leseaw/PrntrBoard/PrntrBoardV1.kicad_pcb

## KiCad design PrntrBoardV1.kicad_pcb (2019-01-21)

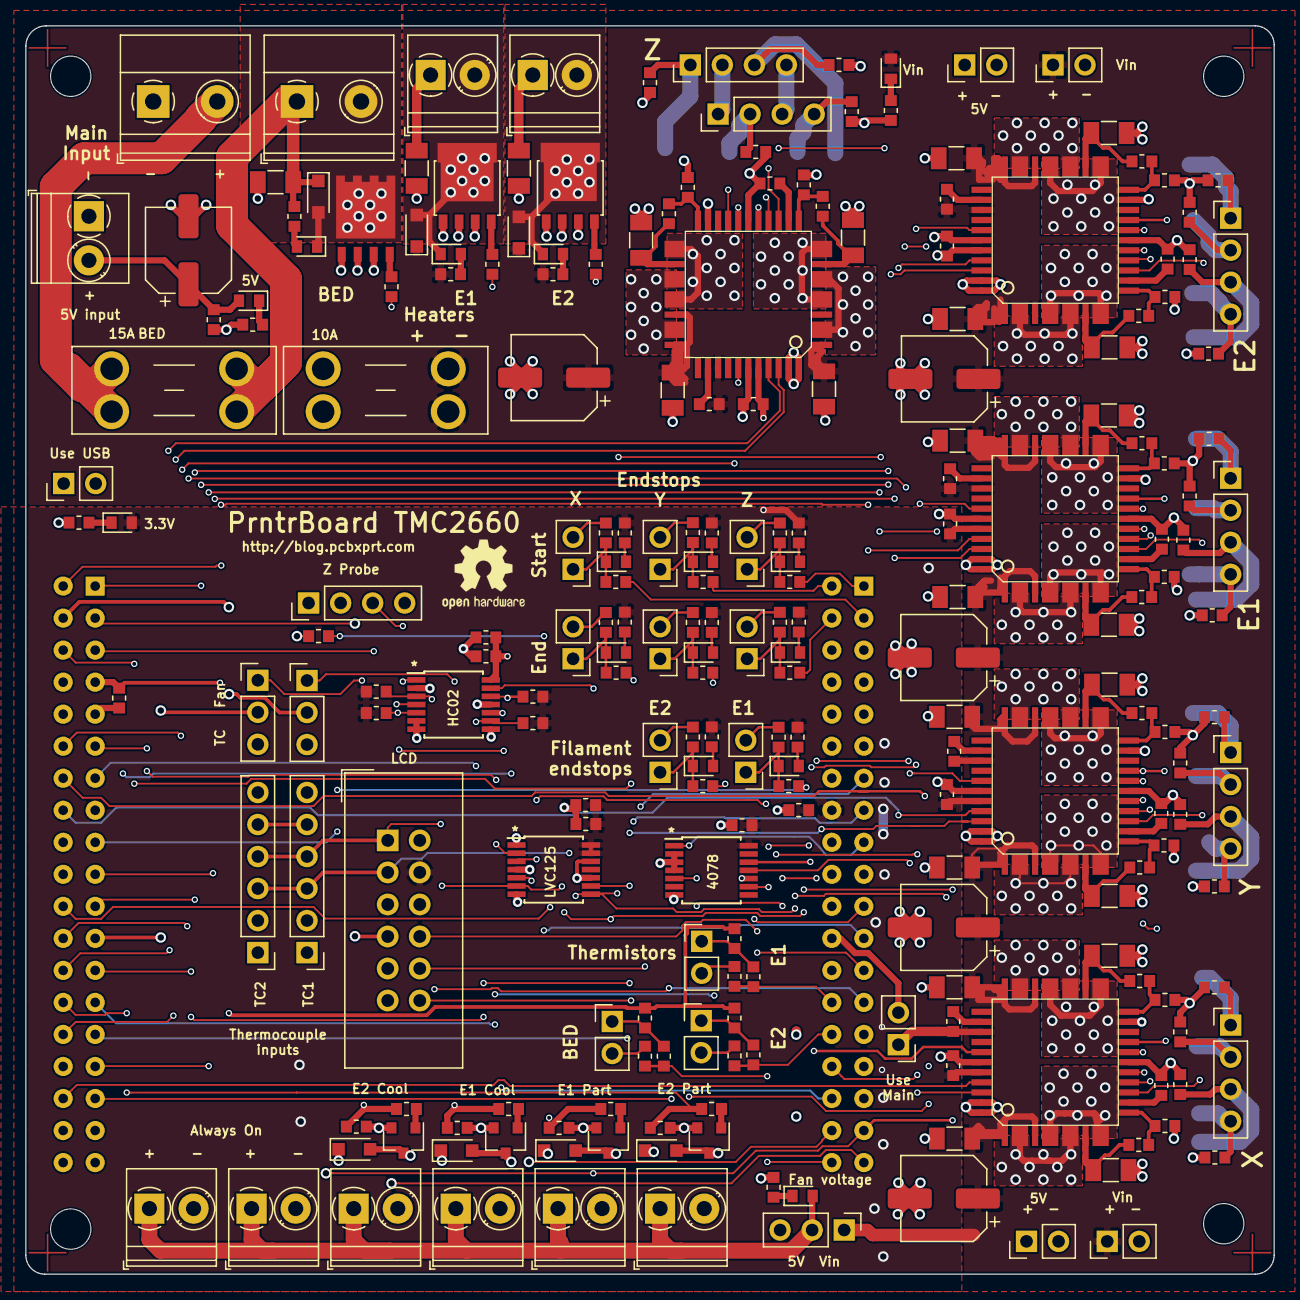
[picture p1: board PrntrBoardV1.kicad_pcb from above]

Board: 4 copper layers, 99.0 x 99.0 mm, 238 parts (1 on the bottom side), 165 nets.

Parts:
C1, C5: 10uF 10V; C_0603_1608Metric
C2: 100uF; CP_Elec_6.3x7.7
C3, C6, C8, C22, C23, C37, C38, C51, C52, C65, C66, C79, C80, C82: 1000pF; C_0603_1608Metric
C4, C7, C9, C15, C30, C44, C58, C72: 0.1uF; C_0603_1608Metric
C10, C11, C24, C25, C26, C39, C40, C53, C54, C67, C68, C81, C83: 10uF 50V; C_1206_3216Metric
C12, C27, C41, C55, C69: 100uF 35V; CP_Elec_6.3x7.7
C13, C28, C42, C56, C70: 0.1uF 50V; C_0603_1608Metric
C14, C29, C43, C57, C71: 0.47uF; C_0603_1608Metric
C16, C21, C31, C36, C45, C50, C59, C64, C73, C78: 0.01uF X7R 10% 50V; C_0603_1608Metric
C17, C18, C19, C20, C32, C33, C34, C35, C46, C47, C48, C49, C60, C61, C62, C63, C74, C75, C76, C77: 1000pF >50V; C_0603_1608Metric
D1, D2, D3, D4, D5, D6, D8, D9, D10, D11, D12, D13, D14, D15, D17: LED; LED_0603_1608Metric
D7, D16, D18, D19, D20, D21, D22: 1N4148; D_SOD-323_HandSoldering
F1: 10A; Fuseholder_Blade_Mini_Keystone_3568
F2: 15A; Fuseholder_Blade_Mini_Keystone_3568
FID1, FID2, FID3, FID4: Fiducial; Fiducial_1mm_Dia_2.54mm_Outer_CopperTop
J1: 12-24V; TerminalBlock_Phoenix_MKDS-1,5-2-5.08_1x02_P5.08mm_Horizont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
J2: EXT 5V; TerminalBlock_Phoenix_PT-1,5-2-3.5-H_1x02_P3.50mm_Horizontal
J3, J4: Vin; PinHeader_1x02_P2.54mm_Vertical
J5, J6: 5V; PinHeader_1x02_P2.54mm_Vertical
J7: Bed Heater; TerminalBlock_Phoenix_MKDS-1,5-2-5.08_1x02_P5.08mm_Horizont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
J8: Z Probe; PinHeader_1x04_P2.54mm_Vertical
J9: E0 Cool; TerminalBlock_Phoenix_PT-1,5-2-3.5-H_1x02_P3.50mm_Horizontal
J10: E0 Part; TerminalBlock_Phoenix_PT-1,5-2-3.5-H_1x02_P3.50mm_Horizontal
J11: E1 Cool; TerminalBlock_Phoenix_PT-1,5-2-3.5-H_1x02_P3.50mm_Horizontal
J12: E1 Part; TerminalBlock_Phoenix_PT-1,5-2-3.5-H_1x02_P3.50mm_Horizontal
J13: Always On Fan 1; TerminalBlock_Phoenix_PT-1,5-2-3.5-H_1x02_P3.50mm_Horizontal
J14: Always On Fan 2; TerminalBlock_Phoenix_PT-1,5-2-3.5-H_1x02_P3.50mm_Horizontal
J15: TC1; PinHeader_1x06_P2.54mm_Vertical
J16: TC2; PinHeader_1x06_P2.54mm_Vertical
J17, J31: Probe; PinHeader_1x02_P2.54mm_Vertical
J18, J32: Extruder Heater; TerminalBlock_Phoenix_PT-1,5-2-3.5-H_1x02_P3.50mm_Horizontal
J19, J27, J28, J29, J30, J33: Stepper; PinHeader_1x04_P2.54mm_Vertical
J20, J34, J35: Thermistor; PinHeader_1x02_P2.54mm_Vertical
J21, J23, J25: Max; PinHeader_1x02_P2.54mm_Vertical
J22, J24, J26: Min; PinHeader_1x02_P2.54mm_Vertical
J36: LCD; IDC-Header_2x06_P2.54mm_Vertical
JP1: E1_TC2; PinHeader_1x03_P2.54mm_Vertical
JP2: Use VIn; PinHeader_1x02_P2.54mm_Vertical
JP3: Use USB; PinHeader_1x02_P2.54mm_Vertical
JP4: E0_TC1; PinHeader_1x03_P2.54mm_Vertical
JP5: FAN Voltage select; PinHeader_1x03_P2.54mm_Vertical
LOGO1: Logo_Open_Hardware_Large; OSHW-Logo2_7.3x6mm_SilkScreen
MK1: Mounting_Hole; MountingHole_3.2mm_M3
MK2, MK3, MK4: Mounting_Hole_3mm; MountingHole_3.2mm_M3
R1, R3, R4, R5, R6, R7, R9, R15, R17, R19, R25, R27, R33, R35, R41, R43, R49, R51, R53, R55, R57, R58, R60, R62, R64: 10k; R_0603_1608Metric
R2, R8, R14, R24, R26, R32, R34, R40, R42, R48, R59, R61, R63, R65: 1k; R_0603_1608Metric
R10, R12, R20, R22, R28, R30, R36, R38, R44, R46: 22R; R_0603_1608Metric
R11, R13, R21, R23, R29, R31, R37, R39, R45, R47: 0R051; R_1206_3216Metric
R16, R50, R54: 4k7 1%; R_0603_1608Metric
R18, R52, R56: 180R; R_0603_1608Metric
TR1, TR2: PSMN7R0-30YL; SOT-669_LFPAK
TR3: BSC011N03LS; PG-TDSON-8-FL
TR4, TR5, TR6, TR7: SI2318CDS; SOT-23
U1: NUCLEO-64; Nucleo-64
U2: 4078; TSSOP-14_4.4x5mm_P0.65mm
U3: 74HCT02; TSSOP-14_4.4x5mm_P0.65mm
U4: 74LVC125; TSSOP-14_4.4x5mm_P0.65mm
U5, U6, U7, U8, U9: TMC2660

Connections:
/3.3V: C1.1, C4.1, C8.1, C9.1, C15.1, C30.1, C44.1, C58.1, C72.1, D2.2, J36.4, R3.1, R4.1, R5.1, R6.1, R14.1, R24.1, R26.1, R32.1, R34.1, R40.1, R42.1, R48.1, U1.16, U2.14, U4.13, U4.14, U5.40, U6.40, U7.40, U8.40, U9.40
/5V: C2.1, C3.1, C6.1, C7.1, D3.2, J2.2, J5.1, J6.1, J8.4, J15.1, J16.1, J36.2, JP3.2, JP5.3, U1.6, U3.14
/AVREF: C5.1, R16.1, R50.1, R54.1, U1.45
/BED_PWM_IN: R6.2, U1.34, U3.5
/BED_TEMP: C82.1, R55.1, U1.38
/BTN_IN: J36.8, U1.25
/E0 Cooling Fan/OUT: D19.2, J9.2, TR4.D
/E0 Cooling Fan/V_FAN: D4.2, D19.1, D20.1, D21.1, D22.1, J9.1, J10.1, J11.1, J12.1, J13.1, J14.1, JP5.2
/E0 Part Fan/OUT: D20.2, J10.2, TR5.D
/E0_COOL_PWM: JP4.1, R58.1, R59.2
/E0_COOL_TC1: JP4.2, U1.42
/E0_DIR: U1.40, U5.41
/E0_END: R15.1, U1.55
/E0_PART_PWM: R60.1, R61.2, U1.60
/E0_PWM: R18.2, U3.10
/E0_PWM_IN: R4.2, U1.51, U3.9
/E0_STEP: U1.57, U5.42
/E0_TEMP: C23.1, R17.1, U1.28
/E1 Cooling Fan/OUT: D21.2, J11.2, TR6.D
/E1 Part Fan/OUT: D22.2, J12.2, TR7.D
/E1_COOL_PWM: JP1.1, R62.1, R63.2
/E1_COOL_TC2: JP1.2, U1.61
/E1_DIR: U1.59, U9.41
/E1_END: R49.1, U1.21
/E1_PART_PWM: R64.1, R65.2, U1.66
/E1_PWM: R52.2, U3.13
/E1_PWM_IN: R5.2, U1.53, U3.12
/E1_STEP: U1.39, U9.42
/E1_TEMP: C80.1, R51.1, U1.30
/ENC_A: J36.10, U1.13
/ENC_B: J36.12, U1.15
/Heated Bed/HEATER: D17.1, D18.2, J7.2, TR3.D
/Heated Bed/PWM: R56.2, U3.4
/Heated Bed/V_HEAT: C83.1, D18.1, F2.2, J7.1, R57.1
/LCD_A0: J36.5, U1.43
/MISO: J15.5, J16.5, U1.35, U5.14, U6.14, U7.14, U8.14, U9.14
/MOSI: U1.36, U4.5
/MOSI_BUF: J15.4, J16.4, J36.1, U4.6, U5.15, U6.15, U7.15, U8.15, U9.15
/MotorControl/E0/Driver/MOTA1: C17.2, J19.3, U5.2.3, U5.7.8
/MotorControl/E0/Driver/MOTA2: C18.2, J19.4, U5.5.6, U5.10.1
/MotorControl/E0/Driver/MOTB1: C19.2, J19.1, U5.26.7, U5.31.2
/MotorControl/E0/Driver/MOTB2: C20.2, J19.2, U5.23.4, U5.28.9
/MotorControl/E0/Fimalent Detect/SENSOR: C22.1, D5.1, J17.1, R15.2
/MotorControl/E0/Heating/HEATER: D6.1, D7.2, J18.2, TR1.D
/MotorControl/E0/~ENABLE: U4.3, U5.19, U6.19, U7.19, U8.19, U9.19
/MotorControl/E0_SG: U2.9, U5.38
/MotorControl/E1/Driver/MOTA1: C74.2, J33.3, U9.2.3, U9.7.8
/MotorControl/E1/Driver/MOTA2: C75.2, J33.4, U9.5.6, U9.10.1
/MotorControl/E1/Driver/MOTB1: C76.2, J33.1, U9.26.7, U9.31.2
/MotorControl/E1/Driver/MOTB2: C77.2, J33.2, U9.23.4, U9.28.9
/MotorControl/E1/Fimalent Detect/SENSOR: C79.1, D14.1, J31.1, R49.2
/MotorControl/E1/Heating/HEATER: D15.1, D16.2, J32.2, TR2.D
/MotorControl/E1_SG: U2.5, U9.38
/MotorControl/X Axis/MOTA1: C32.2, J27.3, U6.2.3, U6.7.8
/MotorControl/X Axis/MOTA2: C33.2, J27.4, U6.5.6, U6.10.1
/MotorControl/X Axis/MOTB1: C34.2, J27.1, U6.26.7, U6.31.2
/MotorControl/X Axis/MOTB2: C35.2, J27.2, U6.23.4, U6.28.9
/MotorControl/X Axis/MaxStop/SENSOR: C37.1, D8.1, J21.1, R25.2
/MotorControl/X Axis/MinStop/SENSOR: C38.1, D9.1, J22.1, R27.2
/MotorControl/X_SG: U2.12, U6.38
/MotorControl/Y Axis/MOTA1: C46.2, J28.3, U7.2.3, U7.7.8
/MotorControl/Y Axis/MOTA2: C47.2, J28.4, U7.5.6, U7.10.1
/MotorControl/Y Axis/MOTB1: C48.2, J28.1, U7.26.7, U7.31.2
/MotorControl/Y Axis/MOTB2: C49.2, J28.2, U7.23.4, U7.28.9
/MotorControl/Y Axis/MaxStop/SENSOR: C51.1, D10.1, J23.1, R33.2
/MotorControl/Y Axis/MinStop/SENSOR: C52.1, D11.1, J24.1, R35.2
/MotorControl/Y_SG: U2.11, U7.38
/MotorControl/Z Axis/MOTA1: C60.2, J30.3, U8.2.3, U8.7.8
/MotorControl/Z Axis/MOTA2: C61.2, J29.4, U8.5.6, U8.10.1
/MotorControl/Z Axis/MOTB1: C62.2, J30.1, U8.26.7, U8.31.2
/MotorControl/Z Axis/MOTB2: C63.2, J29.2, U8.23.4, U8.28.9
/MotorControl/Z Axis/MaxStop/SENSOR: C65.1, D12.1, J25.1, R41.2
/MotorControl/Z Axis/MinStop/SENSOR: C66.1, D13.1, J26.1, R43.2
/MotorControl/Z Motors/Motor1/MOTA1: J29.3, J30.4
/MotorControl/Z Motors/Motor1/MOTB1: J29.1, J30.2
/MotorControl/Z_SG: U2.10, U8.38
/SCK: U1.63, U4.9
/SCK_BUF: J15.3, J16.3, J36.3, U4.8, U5.16, U6.16, U7.16, U8.16, U9.16
/STALL: U1.17, U2.1
/VBUS: JP3.1, U1.46
/V_MOTORS: C10.1, C11.1, C12.1, C13.1, C24.1, C25.1, C26.1, C27.1, C28.1, C39.1, C40.1, C41.1, C42.1, C53.1, C54.1, C55.1, C56.1, C67.1, C68.1, C69.1, C70.1, C81.1, D1.2, D7.1, D16.1, F1.1, J3.1, J4.1, J18.1, J32.1, JP2.1, JP5.1, R19.1, R53.1, U5.1, U5.4, U5.30, U5.33, U5.36, U6.1, U6.4, U6.30, U6.33, U6.36, U7.1, U7.4, U7.30, U7.33, U7.36, U8.1, U8.4, U8.30, U8.33, U8.36, U9.1, U9.4, U9.30, U9.33, U9.36
/Vin: F1.2, F2.1, J1.2
/X_DIR: U1.72, U6.41
/X_END: R25.1, U1.4
/X_START: R27.1, U1.1
/X_STEP: U1.32, U6.42
/Y_DIR: U1.54, U7.41
/Y_END: R33.1, U1.65
/Y_START: R35.1, U1.2
/Y_STEP: U1.44, U7.42
/Z_DIR: U1.64, U8.41
/Z_END: R41.1, U1.67
/Z_PROBE_IN: R8.1, U1.23
/Z_PROBE_MOD: R3.2, U1.27, U3.3
/Z_PROBE_MOD_BUF: J8.3, U3.1
/Z_START: R43.1, U1.3
/Z_STEP: U1.68, U8.42
/~E0_CS: U1.69, U5.18
/~E1_CS: U1.62, U9.18
/~EN_MOTORS: U1.49, U4.2
/~LCD_CS: J36.9, U1.37
/~LCD_RESET: J36.7, U1.41
/~TC1_CS: J15.6, JP4.3
/~TC2_CS: J16.6, JP1.3
/~X_CS: U1.71, U6.18
/~Y_CS: U1.52, U7.18
/~Z_CS: U1.50, U8.18
GND: C1.2, C2.2, C3.2, C4.2, C5.2, C6.2, C7.2, C8.2, C9.2, C10.2, C11.2, C12.2, C14.1, C15.2, C16.2, C17.1, C18.1, C19.1, C20.1, C21.2, C22.2, C23.2, C24.2, C25.2, C26.2, C27.2, C29.1, C30.2, C31.2, C32.1, C33.1, C34.1, C35.1, C36.2, C37.2, C38.2, C39.2, C40.2, C41.2, C43.1, C44.2, C45.2, C46.1, C47.1, C48.1, C49.1, C50.2, C51.2, C52.2, C53.2, C54.2, C55.2, C57.1, C58.2, C59.2, C60.1, C61.1, C62.1, C63.1, C64.2, C65.2, C66.2, C67.2, C68.2, C69.2, C71.1, C72.2, C73.2, C74.1, C75.1, C76.1, C77.1, C78.2, C79.2, C80.2, C81.2, C82.2, C83.2, J1.1, J2.1, J3.2, J4.2, J5.2, J6.2, J8.2, J13.2, J14.2, J15.2, J16.2, J17.2, J20.2, J21.2, J22.2, J23.2, J24.2, J25.2, J26.2, J31.2, J34.2, J35.2, J36.6, J36.11, R1.2, R2.1, R7.2, R9.2, R11.2, R13.2, R21.2, R23.2, R29.2, R31.2, R37.2, R39.2, R45.2, R47.2, R58.2, R60.2, R62.2, R64.2, TR1.S, TR2.S, TR3.S, TR4.S, TR5.S, TR6.S, TR7.S, U1.8, U1.19, U1.20, U1.22, U1.47, U1.58, U1.70, U2.2, U2.3, U2.4, U2.7, U3.2, U3.6, U3.7, U3.8, U3.11, U4.1, U4.4, U4.7, U4.10, U4.12, U5.17, U5.21, U5.39, U5.43, U5.44, U6.17, U6.21, U6.39, U6.43, U6.44, U7.17, U7.21, U7.39, U7.43, U7.44, U8.17, U8.21, U8.39, U8.43, U8.44, U9.17, U9.21, U9.39, U9.43, U9.44
unnamed: C13.2, U5.35
unnamed: C14.2, U5.13
unnamed: C16.1, R10.1, U5.22
unnamed: C21.1, R12.1, U5.12
unnamed: C28.2, U6.35
unnamed: C29.2, U6.13
unnamed: C31.1, R20.1, U6.22
unnamed: C36.1, R22.1, U6.12
unnamed: C42.2, U7.35
unnamed: C43.2, U7.13
unnamed: C45.1, R28.1, U7.22
unnamed: C50.1, R30.1, U7.12
unnamed: C56.2, U8.35
unnamed: C57.2, U8.13
unnamed: C59.1, R36.1, U8.22
unnamed: C64.1, R38.1, U8.12
unnamed: C70.2, U9.35
unnamed: C71.2, U9.13
unnamed: C73.1, R44.1, U9.22
unnamed: C78.1, R46.1, U9.12
unnamed: D1.1, R1.1
unnamed: D2.1, R2.2
unnamed: D3.1, R7.1
unnamed: D4.1, R9.1
unnamed: D5.2, R14.2
unnamed: D6.2, R19.2
unnamed: D8.2, R24.2
unnamed: D9.2, R26.2
unnamed: D10.2, R32.2
unnamed: D11.2, R34.2
unnamed: D12.2, R40.2
unnamed: D13.2, R42.2
unnamed: D14.2, R48.2
unnamed: D15.2, R53.2
unnamed: D17.2, R57.2
unnamed: J8.1, R8.2
unnamed: J20.1, R16.2, R17.2
unnamed: J34.1, R50.2, R51.2
unnamed: J35.1, R54.2, R55.2
unnamed: JP2.2, U1.24
unnamed: R10.2, R11.1, U5.25
unnamed: R12.2, R13.1, U5.9
unnamed: R18.1, TR1.G
unnamed: R20.2, R21.1, U6.25
unnamed: R22.2, R23.1, U6.9
unnamed: R28.2, R29.1, U7.25
unnamed: R30.2, R31.1, U7.9
unnamed: R36.2, R37.1, U8.25
unnamed: R38.2, R39.1, U8.9
unnamed: R44.2, R45.1, U9.25
unnamed: R46.2, R47.1, U9.9
unnamed: R52.1, TR2.G
unnamed: R56.1, TR3.G
unnamed: R59.1, TR4.G
unnamed: R61.1, TR5.G
unnamed: R63.1, TR6.G
unnamed: R65.1, TR7.G
