leseaw/PrntrBoard/(commit log)

2018-04-15 Added clock line for the motor drivers.
    [AxisControl.sch, Extruder.sch, MotorControl.sch, MotorDriver_TMC2660.sch, PrntrBoardV1.sch]
2018-04-15 Annotate schematics. Select footprints for the added jumpers.
    [AxisControl.sch, BasicHeater.sch, Endstop.sch, FanControl.sch, MotorConnect.sch, MotorDriver_TMC2660.sch, PrntrBoardV1.sch]
2018-04-15 All routed again. Clock jumpers on the bottom side.
    [PrntrBoardV1.kicad_pcb]
2018-04-15 Add motorl clock jumper labels.
    [PrntrBoardV1.kicad_pcb]
2018-05-04 Added gerber files and Pick and Place file.
    [PrntrBoardV1-B.Cu.gbl, PrntrBoardV1-B.Mask.gbs, PrntrBoardV1-B.Paste.gbp, PrntrBoardV1-B.SilkS.gbo, PrntrBoardV1-Edge.Cuts.gm1, PrntrBoardV1-F.Cu.gtl, PrntrBoardV1-F.Mask.gts, PrntrBoardV1-F.Paste.gtp]
2018-05-04 Set board origin.
    [PrntrBoardV1-B.Cu.gbl, PrntrBoardV1-B.Mask.gbs, PrntrBoardV1-B.Paste.gbp, PrntrBoardV1-B.SilkS.gbo, PrntrBoardV1-Edge.Cuts.gm1, PrntrBoardV1-F.Cu.gtl, PrntrBoardV1-F.Mask.gts, PrntrBoardV1-F.Paste.gtp]
2018-05-09 Update connector components. Correct bad capacitor value.
    [AxisControl.sch, Extruder.sch, PrntrBoardV1.sch]
2018-06-23 Update FID* to SMD from virtual component, so they show up in the pick-and-place output.
    [PrntrBoardV1.kicad_pcb]
2018-06-24 Cherry pick path names changes.
    [MotorControl.sch, PrntrBoardV1.kicad_pcb, PrntrBoardV1.sch, PrntrBoardV1_bom_.csv]
2018-07-02 Fix endstops.
    [AxisControl.sch, Endstop.sch]
2018-07-02 Update board with the new endstop configuration.
    [PrntrBoardV1.kicad_pcb]
2019-01-21 Added two fuses, because we have space.
    [MotorControl.sch, PrntrBoardV1.kicad_pcb, PrntrBoardV1.sch]
2019-01-21 Add the Fuse holder model.
